daisuke-ym/pinball/src/main-controller/lcd.md

# SC2004 液晶ディスプレイに表示する内容

```
  01234567890123456789
0 S:a         BMPR SL
1 O E J T TGT #### ##
2 b c d e fff ST BS BT
3 * * * * *** *% *% *%
```

*: テレメトリ - \ | /
%: 値

S: 現在のステージ
  a: 
O: アウトホール
  b: W P
E: エクストラボール
  c: W S
J: ジャンパー
  d: W U
T: タイマー
  e: W C U
TGT: ドロップターゲット
  fff: H U D

BMPR: バンパー
  ####: H *
SL: スリングショット
  ####: H *

ST: スタンダップターゲット
BS: ボールセパレータ
BT: ボールスルー
