daisuke-ym/pinball/PCB/attiny1616-hbridge/attiny1616-hbridge.kicad_pcb

## KiCad design PCB/attiny1616-hbridge/attiny1616-hbridge.kicad_pcb (2026-10-16)

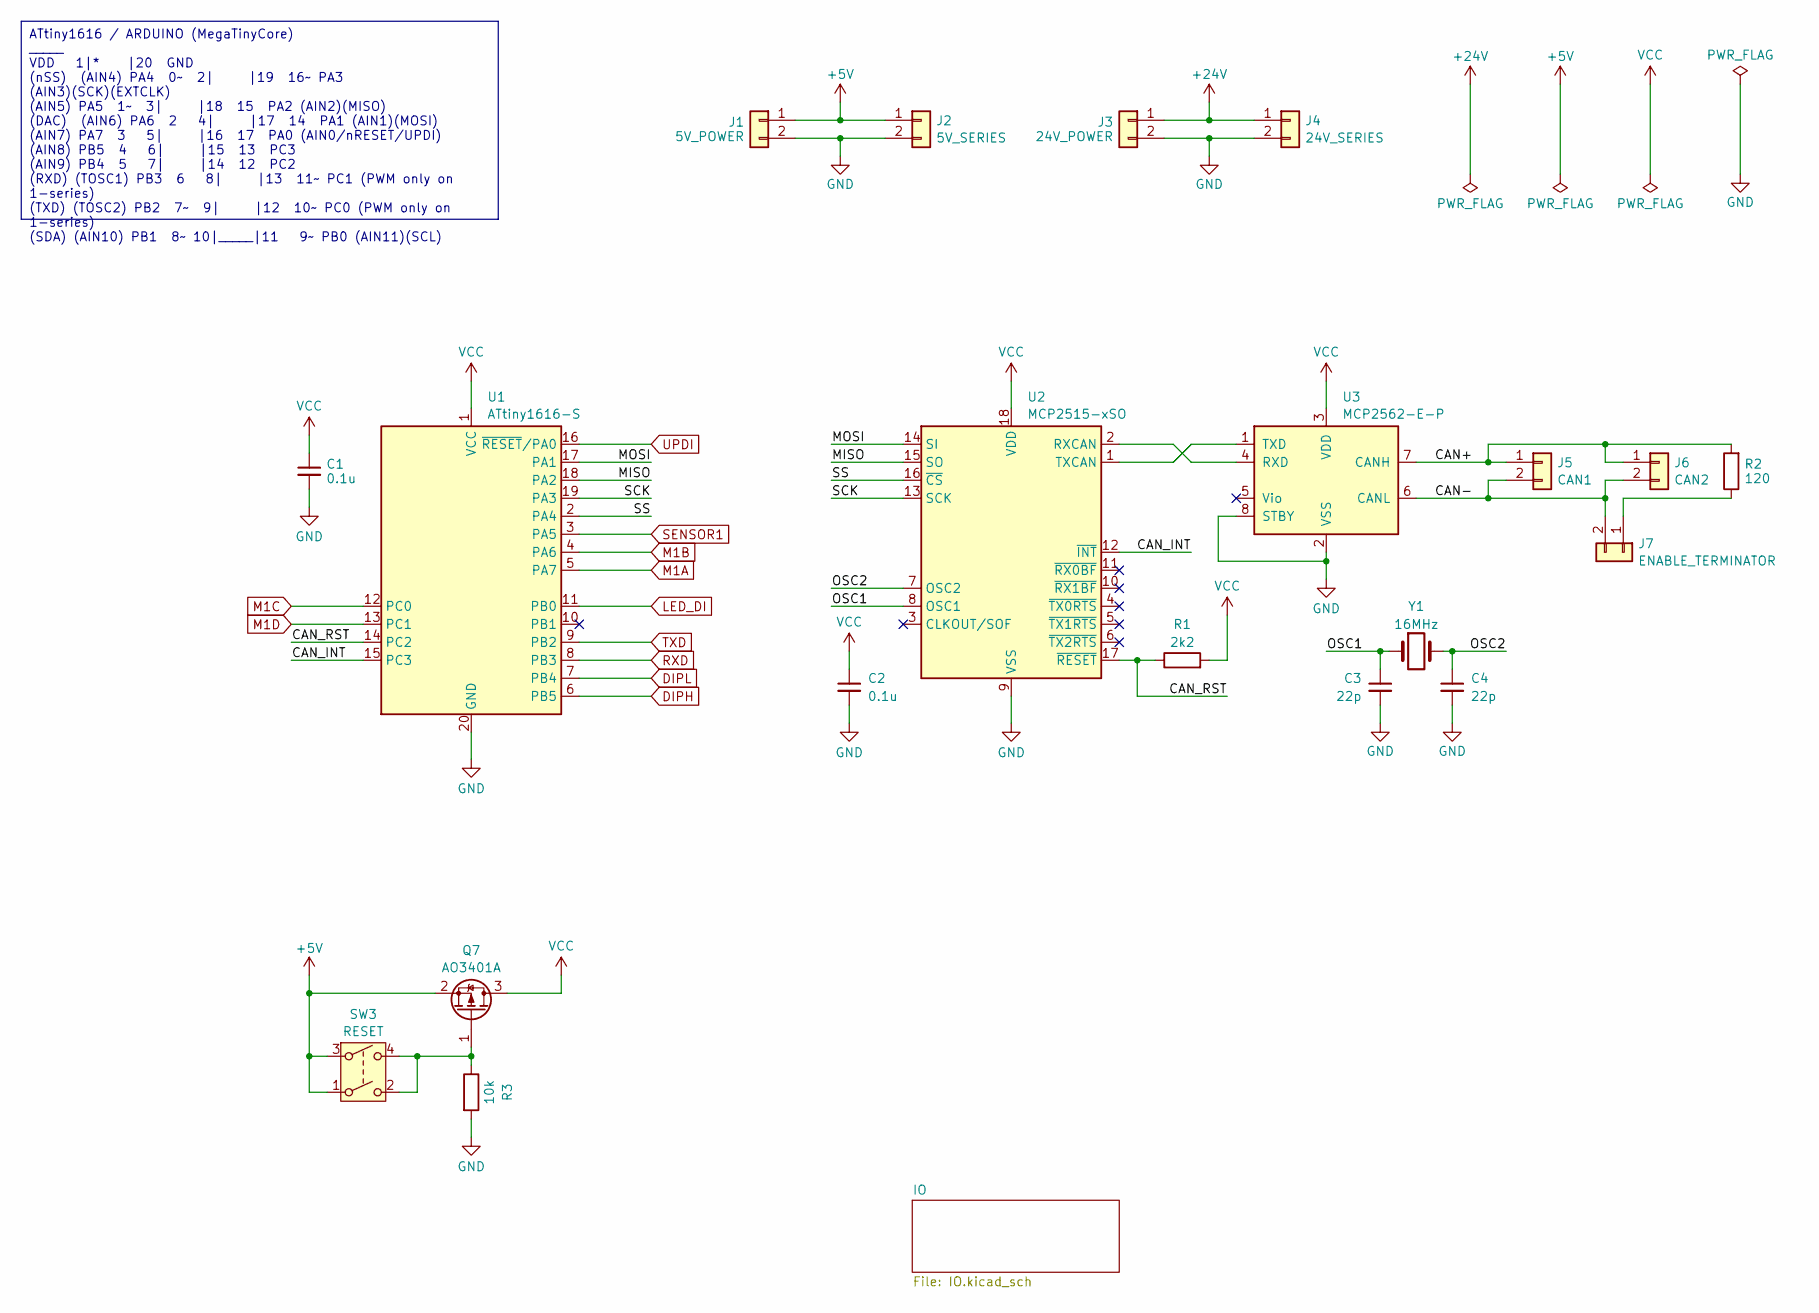
[picture p1: schematic attiny1616-hbridge.kicad_sch]

Parts:
C1, C2: 0.1u; C_0402_1005Metric; LCSC C307331
C3, C4: 22p; C_0402_1005Metric; LCSC C1555
J1: 5V_POWER; JST_XH_B2B-XH-A_1x02_P2.50mm_Vertical
J2: 5V_SERIES; JST_XH_B2B-XH-A_1x02_P2.50mm_Vertical
J3: 24V_POWER; JST_XH_B2B-XH-A_1x02_P2.50mm_Vertical
J4: 24V_SERIES; JST_XH_B2B-XH-A_1x02_P2.50mm_Vertical
J5: CAN1; JST_XH_B2B-XH-A_1x02_P2.50mm_Vertical
J6: CAN2; JST_XH_B2B-XH-A_1x02_P2.50mm_Vertical
J7: ENABLE_TERMINATOR; PinHeader_1x02_P2.54mm_Vertical
Q7: AO3401A; SOT-23; LCSC C15127
R1: 2k2; R_0402_1005Metric; LCSC C25879
R2: 120; R_0402_1005Metric; LCSC C25079
R3: 10k; R_0402_1005Metric; LCSC C25744
SW3: RESET; DTS-6-V-2
U1: ATtiny1616-S; SOIC-20W_7.5x12.8mm_P1.27mm
U2: MCP2515-xSO; DIP-18_W7.62mm_Socket
U3: MCP2562-E-P; DIP-8_W7.62mm
Y1: 16MHz; Crystal_SMD_3225-4Pin_3.2x2.5mm; LCSC C13738

Connections:
+5V: J1.1, J2.1, Q7.2 (S), SW3.1, SW3.3; also elsewhere on the board
+24V: J3.1, J4.1; also elsewhere on the board
/CAN+: J5.1, J6.1, R2.2, U3.7 (CANH)
/CAN-: J5.2, J6.2, J7.2, U3.6 (CANL)
/CAN_INT: U1.15 (PC3), U2.12 (~INT)
/CAN_RST: R1.1, U1.14 (PC2), U2.17 (~RESET)
/MISO: U1.18 (PA2), U2.15 (SO)
/MOSI: U1.17 (PA1), U2.14 (SI)
/OSC1: C3.1, U2.8 (OSC1), Y1.1
/OSC2: C4.1, U2.7 (OSC2), Y1.2
/SCK: U1.19 (PA3), U2.13 (SCK)
/SS: U1.2 (PA4), U2.16 (~CS)
DIPH: U1.6 (PB5); also elsewhere on the board
DIPL: U1.7 (PB4); also elsewhere on the board
GND: C1.2, C2.2, C3.2, C4.2, J1.2, J2.2, J3.2, J4.2, R3.2, U1.20 (GND), U2.9 (VSS), U3.2 (VSS), U3.8 (STBY); also elsewhere on the board
LED_DI: U1.11 (PB0); also elsewhere on the board
M1A: U1.5 (PA7); also elsewhere on the board
M1B: U1.4 (PA6); also elsewhere on the board
M1C: U1.12 (PC0); also elsewhere on the board
M1D: U1.13 (PC1); also elsewhere on the board
unnamed: J7.1, R2.1
unnamed: Q7.1 (G), R3.1, SW3.2, SW3.4
unnamed: U2.2 (RXCAN), U3.4 (RXD)
unnamed: U2.1 (TXCAN), U3.1 (TXD)
RXD: U1.8 (PB3); also elsewhere on the board
SENSOR1: U1.3 (PA5); also elsewhere on the board
TXD: U1.9 (PB2); also elsewhere on the board
UPDI: U1.16 (~RESET/PA0); also elsewhere on the board
VCC: C1.1, C2.1, Q7.3 (D), R1.2, U1.1 (VCC), U2.18 (VDD), U3.3 (VDD)

Notes on the sheet:
ATtiny1616 / ARDUINO (MegaTinyCore) _____ VDD 1|* |20 GND (nSS) (AIN4) PA4 0~ 2| |19 16~ PA3 (AIN3)(SCK)(EXTCLK) (AIN5) PA5 1~ 3| |18 15 PA2 (AIN2)(MISO) (DAC) (AIN6) PA6 2 4| |17 14 PA1 (AIN1)(MOSI) (AIN7) PA7 3 5| |16 17 PA0 (AIN0/nRESET/UPDI) (AIN8) PB5 4 6| |15 13 PC3 (AIN9) PB4 5 7| |14 12 PC2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

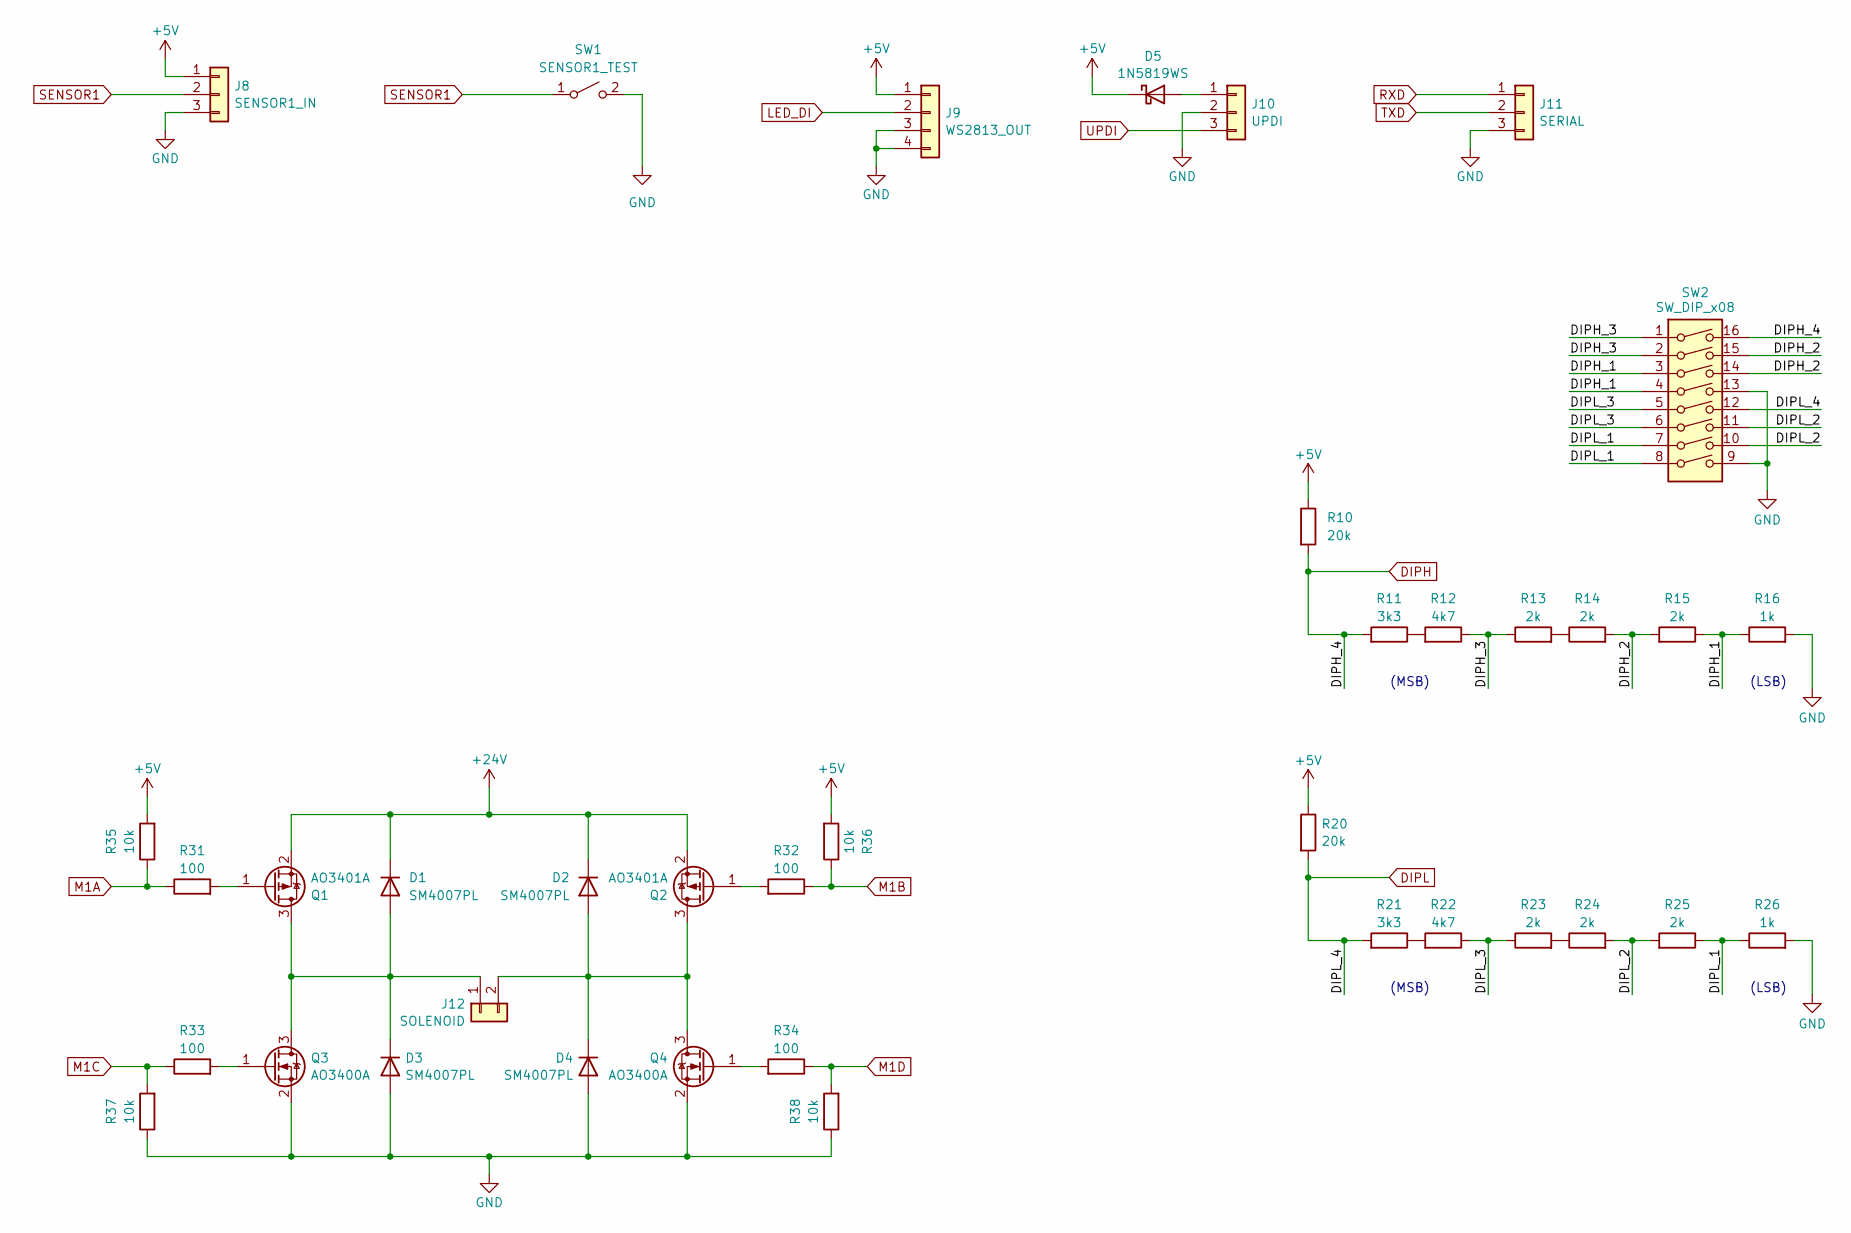
[picture p2: schematic IO.kicad_sch]

Parts:
D1, D2, D3, D4: SM4007PL; D_SOD-123F; LCSC C64898
D5: 1N5819WS; D_SOD-323; LCSC C191023
J8: SENSOR1_IN; JST_XH_B3B-XH-A_1x03_P2.50mm_Vertical
J9: WS2813_OUT; JST_XH_B4B-XH-A_1x04_P2.50mm_Vertical
J10: UPDI; PinHeader_1x03_P2.54mm_Vertical
J11: SERIAL; PinHeader_1x03_P2.54mm_Vertical
J12: SOLENOID; TB111-2-2
Q1, Q2: AO3401A; SOT-23; LCSC C15127
Q3, Q4: AO3400A; SOT-23; LCSC C20917
R10, R20: 20k; R_0402_1005Metric; LCSC C25765
R11, R21: 3k3; R_0402_1005Metric; LCSC C25890
R12, R22: 4k7; R_0402_1005Metric; LCSC C25900
R13, R14, R15, R23, R24, R25: 2k; R_0402_1005Metric; LCSC C4109
R16, R26: 1k; R_0402_1005Metric; LCSC C11702
R31, R32, R33, R34: 100; R_0402_1005Metric; LCSC C25077
R35, R36, R37, R38: 10k; R_0402_1005Metric; LCSC C25744
SW1: SENSOR1_TEST; TS-1088-AR02016; LCSC C720477
SW2: SW_DIP_x08; SW_DIP_SPSTx08_Slide_9.78x22.5mm_W7.62mm_P2.54mm

Connections:
+5V: D5.1 (K), J8.1, J9.1, R10.1, R20.1, R35.2, R36.2; also elsewhere on the board
+24V: D1.1 (K), D2.1 (K), Q1.2 (S), Q2.2 (S); also elsewhere on the board
/IO/DIPH_1: R15.1, R16.1, SW2.3, SW2.4
/IO/DIPH_2: R14.2, R15.2, SW2.14, SW2.15
/IO/DIPH_3: R12.1, R13.1, SW2.1, SW2.2
/IO/DIPL_1: R25.1, R26.1, SW2.7, SW2.8
/IO/DIPL_2: R24.2, R25.2, SW2.10, SW2.11
/IO/DIPL_3: R22.1, R23.1, SW2.5, SW2.6
DIPH: R10.2, R11.2, SW2.16; also elsewhere on the board
DIPL: R20.2, R21.2, SW2.12; also elsewhere on the board
GND: D3.2 (A), D4.2 (A), J8.3, J9.3, J9.4, J10.2, J11.3, Q3.2 (S), Q4.2 (S), R16.2, R26.2, R37.1, R38.1, SW1.2 (B), SW2.9, SW2.13; also elsewhere on the board
LED_DI: J9.2; also elsewhere on the board
M1A: R31.1, R35.1; also elsewhere on the board
M1B: R32.1, R36.1; also elsewhere on the board
M1C: R33.1, R37.2; also elsewhere on the board
M1D: R34.1, R38.2; also elsewhere on the board
unnamed: D1.2 (A), D3.1 (K), J12.1, Q1.3 (D), Q3.3 (D)
unnamed: D2.2 (A), D4.1 (K), J12.2, Q2.3 (D), Q4.3 (D)
unnamed: D5.2 (A), J10.1
unnamed: Q1.1 (G), R31.2
unnamed: Q2.1 (G), R32.2
unnamed: Q3.1 (G), R33.2
unnamed: Q4.1 (G), R34.2
unnamed: R11.1, R12.2
unnamed: R13.2, R14.1
unnamed: R21.1, R22.2
unnamed: R23.2, R24.1
RXD: J11.1; also elsewhere on the board
SENSOR1: J8.2, SW1.1 (A); also elsewhere on the board
TXD: J11.2; also elsewhere on the board
UPDI: J10.3; also elsewhere on the board

Notes on the sheet:
(LSB)
(MSB)

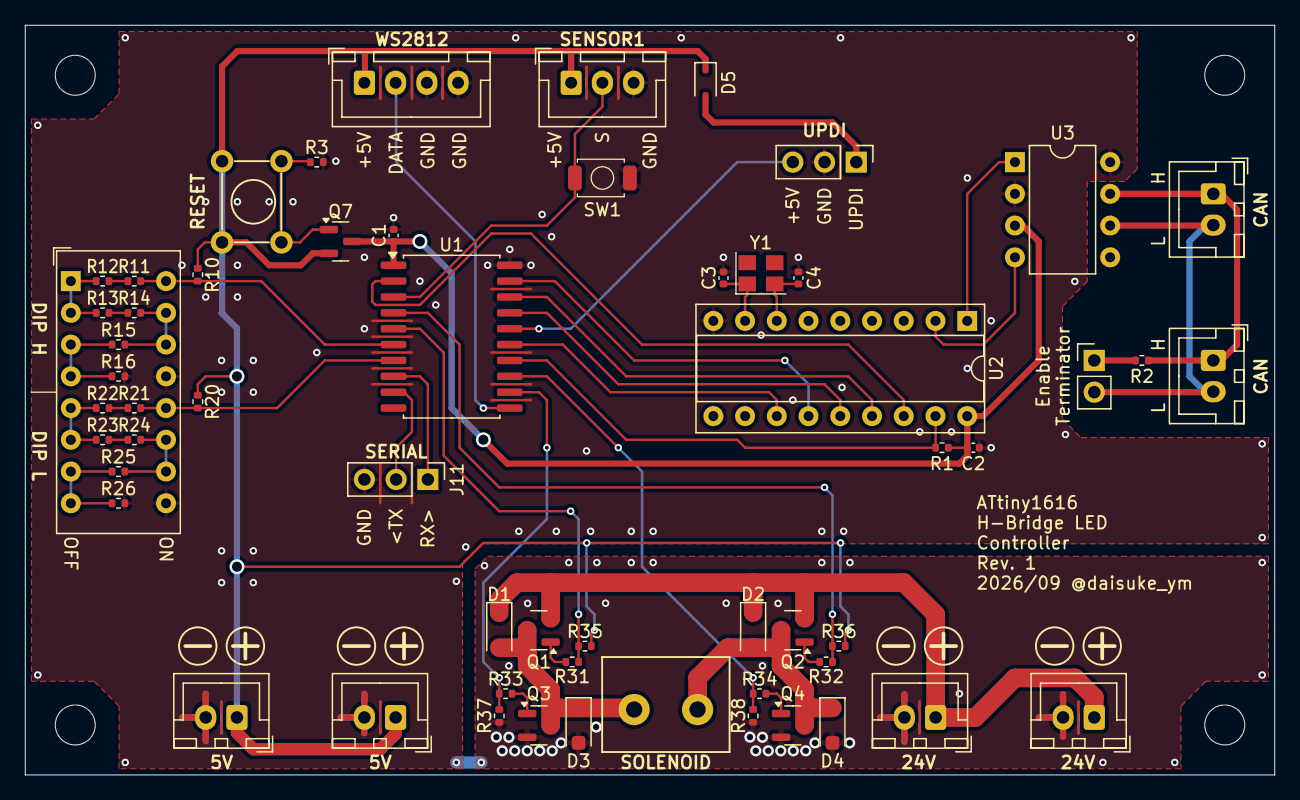
[picture p3: board attiny1616-hbridge.kicad_pcb from above]

Board: 2 copper layers, 100.0 x 60.0 mm, 58 parts (0 on the bottom side), 46 nets.
