daisuke-ym/pinball/PCB/photo-int/photo-int.kicad_pcb

## KiCad design PCB/photo-int/photo-int.kicad_pcb (2026-10-16)

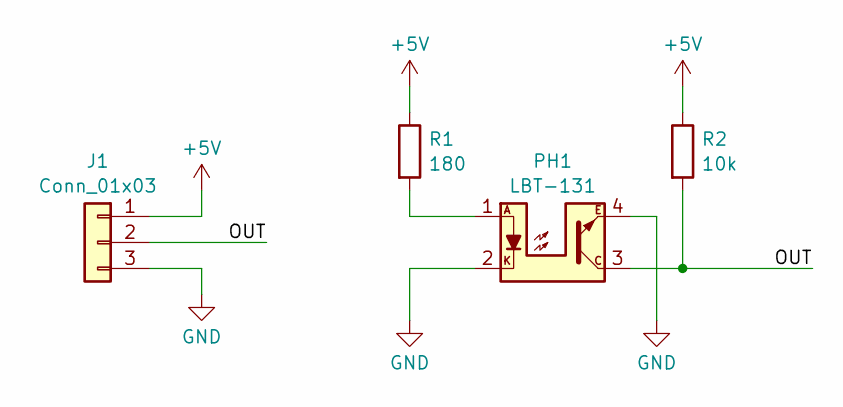
[picture p4: schematic photo-int.kicad_sch]

Parts:
J1: Conn_01x03; PinHeader_1x03_P2.54mm_Vertical
PH1: LBT-131
R1: 180; R_0603_1608Metric_Pad0.98x0.95mm_HandSolder
R2: 10k; R_0603_1608Metric_Pad0.98x0.95mm_HandSolder

Connections:
+5V: J1.1, R1.1, R2.1
/OUT: J1.2, PH1.3, R2.2
GND: J1.3, PH1.2, PH1.4
unnamed: PH1.1, R1.2

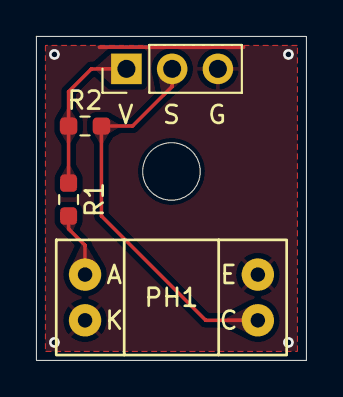
[picture p5: board photo-int.kicad_pcb from above]

Board: 2 copper layers, 15.0 x 18.0 mm, 4 parts (0 on the bottom side), 4 nets.
