daisuke-ym/pinball/PCB/esp32-mainboard/esp32-mainboard.kicad_pcb

## KiCad design PCB/esp32-mainboard/esp32-mainboard.kicad_pcb (2026-10-16)

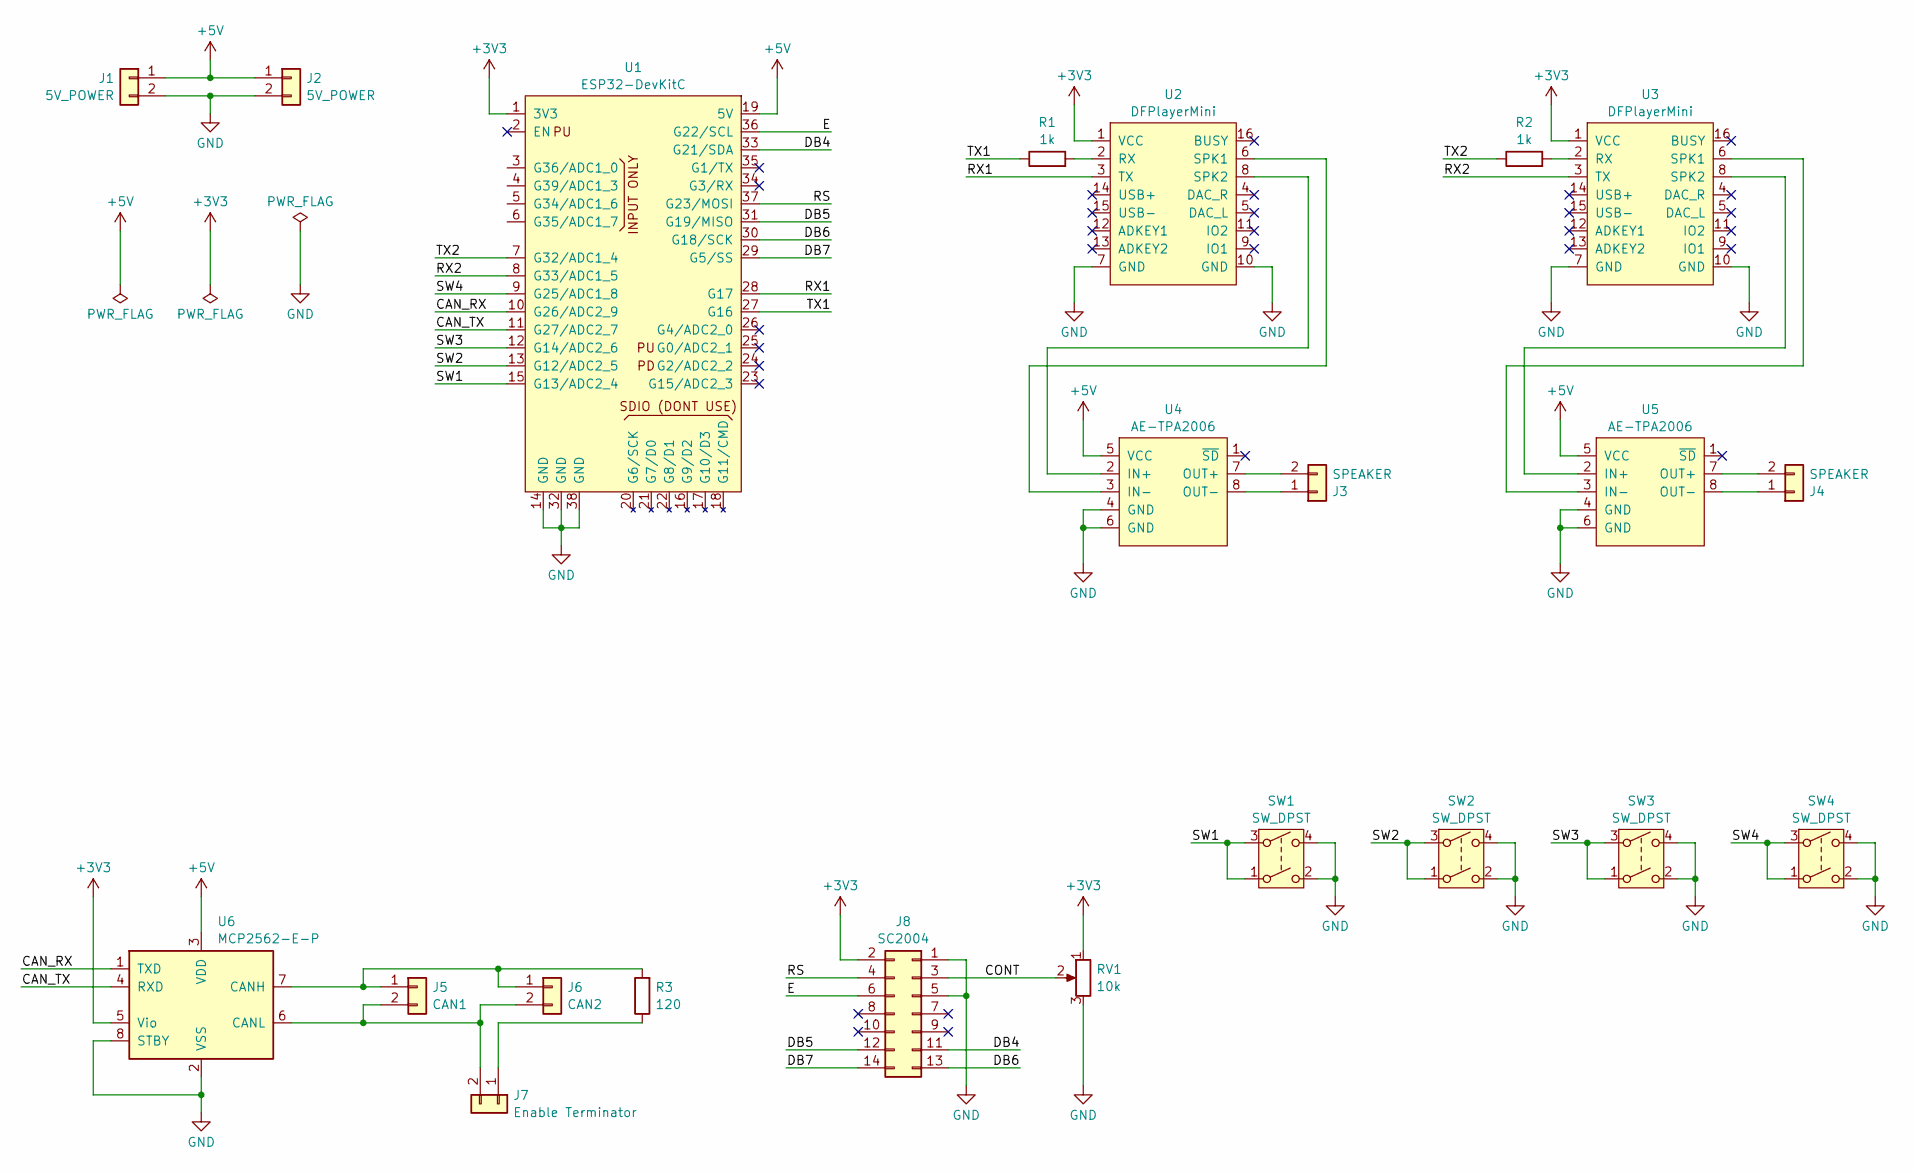
[picture p6: schematic esp32-mainboard.kicad_sch]

Parts:
J1, J2: 5V_POWER; JST_XH_B2B-XH-A_1x02_P2.50mm_Vertical
J3, J4: SPEAKER; JST_XH_B2B-XH-A_1x02_P2.50mm_Vertical
J5: CAN1; JST_XH_B2B-XH-A_1x02_P2.50mm_Vertical
J6: CAN2; JST_XH_B2B-XH-A_1x02_P2.50mm_Vertical
J7: Enable Terminator; PinHeader_1x02_P2.54mm_Vertical
J8: SC2004; PinHeader_2x07_P2.54mm_Vertical
R1, R2: 1k; R_Axial_DIN0207_L6.3mm_D2.5mm_P10.16mm_Horizontal
R3: 120; R_Axial_DIN0207_L6.3mm_D2.5mm_P10.16mm_Horizontal
RV1: 10k; Potentiometer_Bourns_3339P_Vertical
SW1, SW2, SW3, SW4: SW_DPST; DTS-6-V-2
U1: ESP32-DevKitC
U2, U3: DFPlayerMini
U4, U5: AE-TPA2006; PinSocket_1x08_P2.54mm_Vertical
U6: MCP2562-E-P; DIP-8_W7.62mm

Connections:
+3V3: J8.2, RV1.1, U1.1 (3V3), U2.1 (VCC), U3.1 (VCC), U6.5 (Vio)
+5V: J1.1, J2.1, U1.19 (5V), U4.5 (VCC), U5.5 (VCC), U6.3 (VDD)
/CAN_RX: U1.10 (G26/ADC2_9), U6.1 (TXD)
/CAN_TX: U1.11 (G27/ADC2_7), U6.4 (RXD)
/CONT: J8.3, RV1.2
/DB4: J8.11, U1.33 (G21/SDA)
/DB5: J8.12, U1.31 (G19/MISO)
/DB6: J8.13, U1.30 (G18/SCK)
/DB7: J8.14, U1.29 (G5/SS)
/E: J8.6, U1.36 (G22/SCL)
/RS: J8.4, U1.37 (G23/MOSI)
/RX1: U1.28 (G17), U2.3 (TX)
/RX2: U1.8 (G33/ADC1_5), U3.3 (TX)
/SW1: SW1.1, SW1.3, U1.15 (G13/ADC2_4)
/SW2: SW2.1, SW2.3, U1.13 (G12/ADC2_5)
/SW3: SW3.1, SW3.3, U1.12 (G14/ADC2_6)
/SW4: SW4.1, SW4.3, U1.9 (G25/ADC1_8)
/TX1: R1.1, U1.27 (G16)
/TX2: R2.1, U1.7 (G32/ADC1_4)
GND: J1.2, J2.2, J8.1, J8.5, RV1.3, SW1.2, SW1.4, SW2.2, SW2.4, SW3.2, SW3.4, SW4.2, SW4.4, U1.14 (GND), U1.32 (GND), U1.38 (GND), U2.7 (GND), U2.10 (GND), U3.7 (GND), U3.10 (GND), U4.4 (GND), U4.6 (GND), U5.4 (GND), U5.6 (GND), U6.2 (VSS), U6.8 (STBY)
unnamed: J3.1, U4.8 (OUT-)
unnamed: J3.2, U4.7 (OUT+)
unnamed: J4.1, U5.8 (OUT-)
unnamed: J4.2, U5.7 (OUT+)
unnamed: J5.1, J6.1, R3.2, U6.7 (CANH)
unnamed: J5.2, J6.2, J7.2, U6.6 (CANL)
unnamed: J7.1, R3.1
unnamed: R1.2, U2.2 (RX)
unnamed: U2.6 (SPK1), U4.3 (IN-)
unnamed: U2.8 (SPK2), U4.2 (IN+)
unnamed: R2.2, U3.2 (RX)
unnamed: U3.6 (SPK1), U5.3 (IN-)
unnamed: U3.8 (SPK2), U5.2 (IN+)

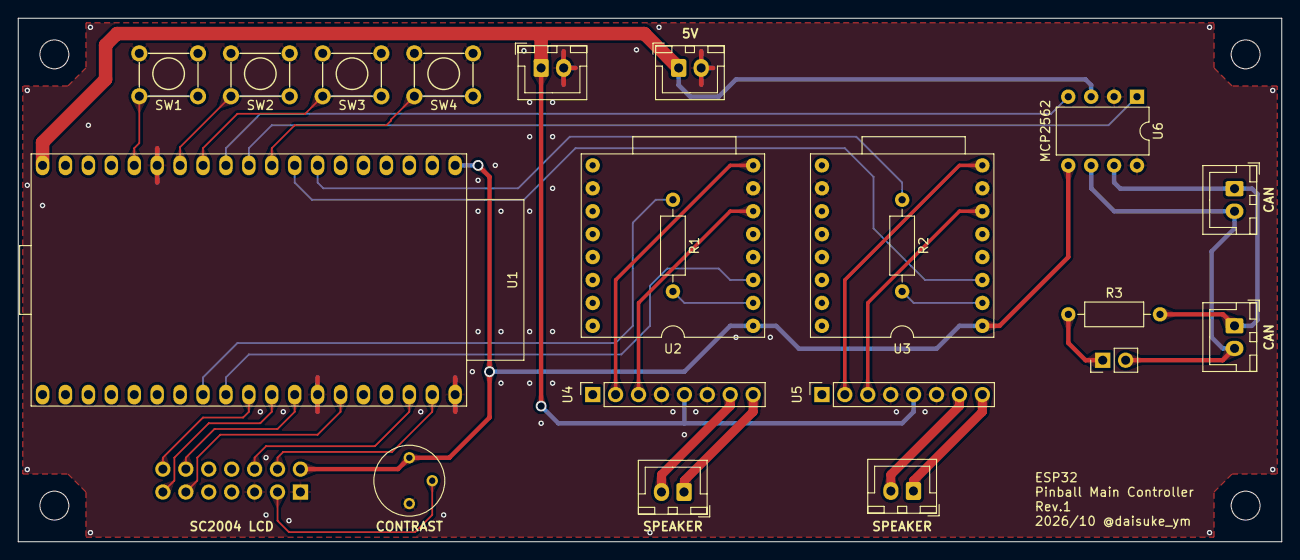
[picture p7: board esp32-mainboard.kicad_pcb from above]

Board: 2 copper layers, 140.0 x 58.0 mm, 26 parts (1 on the bottom side), 33 nets.

Other parts of the board:
MH1, MH2, MH3, MH4: MountingHole_3.2mm_M3
