daisuke-ym/pinball/PCB/attiny1616-spi7seg/attiny1616-spi7seg.kicad_pcb

## KiCad design PCB/attiny1616-spi7seg/attiny1616-spi7seg.kicad_pcb (2026-10-16)

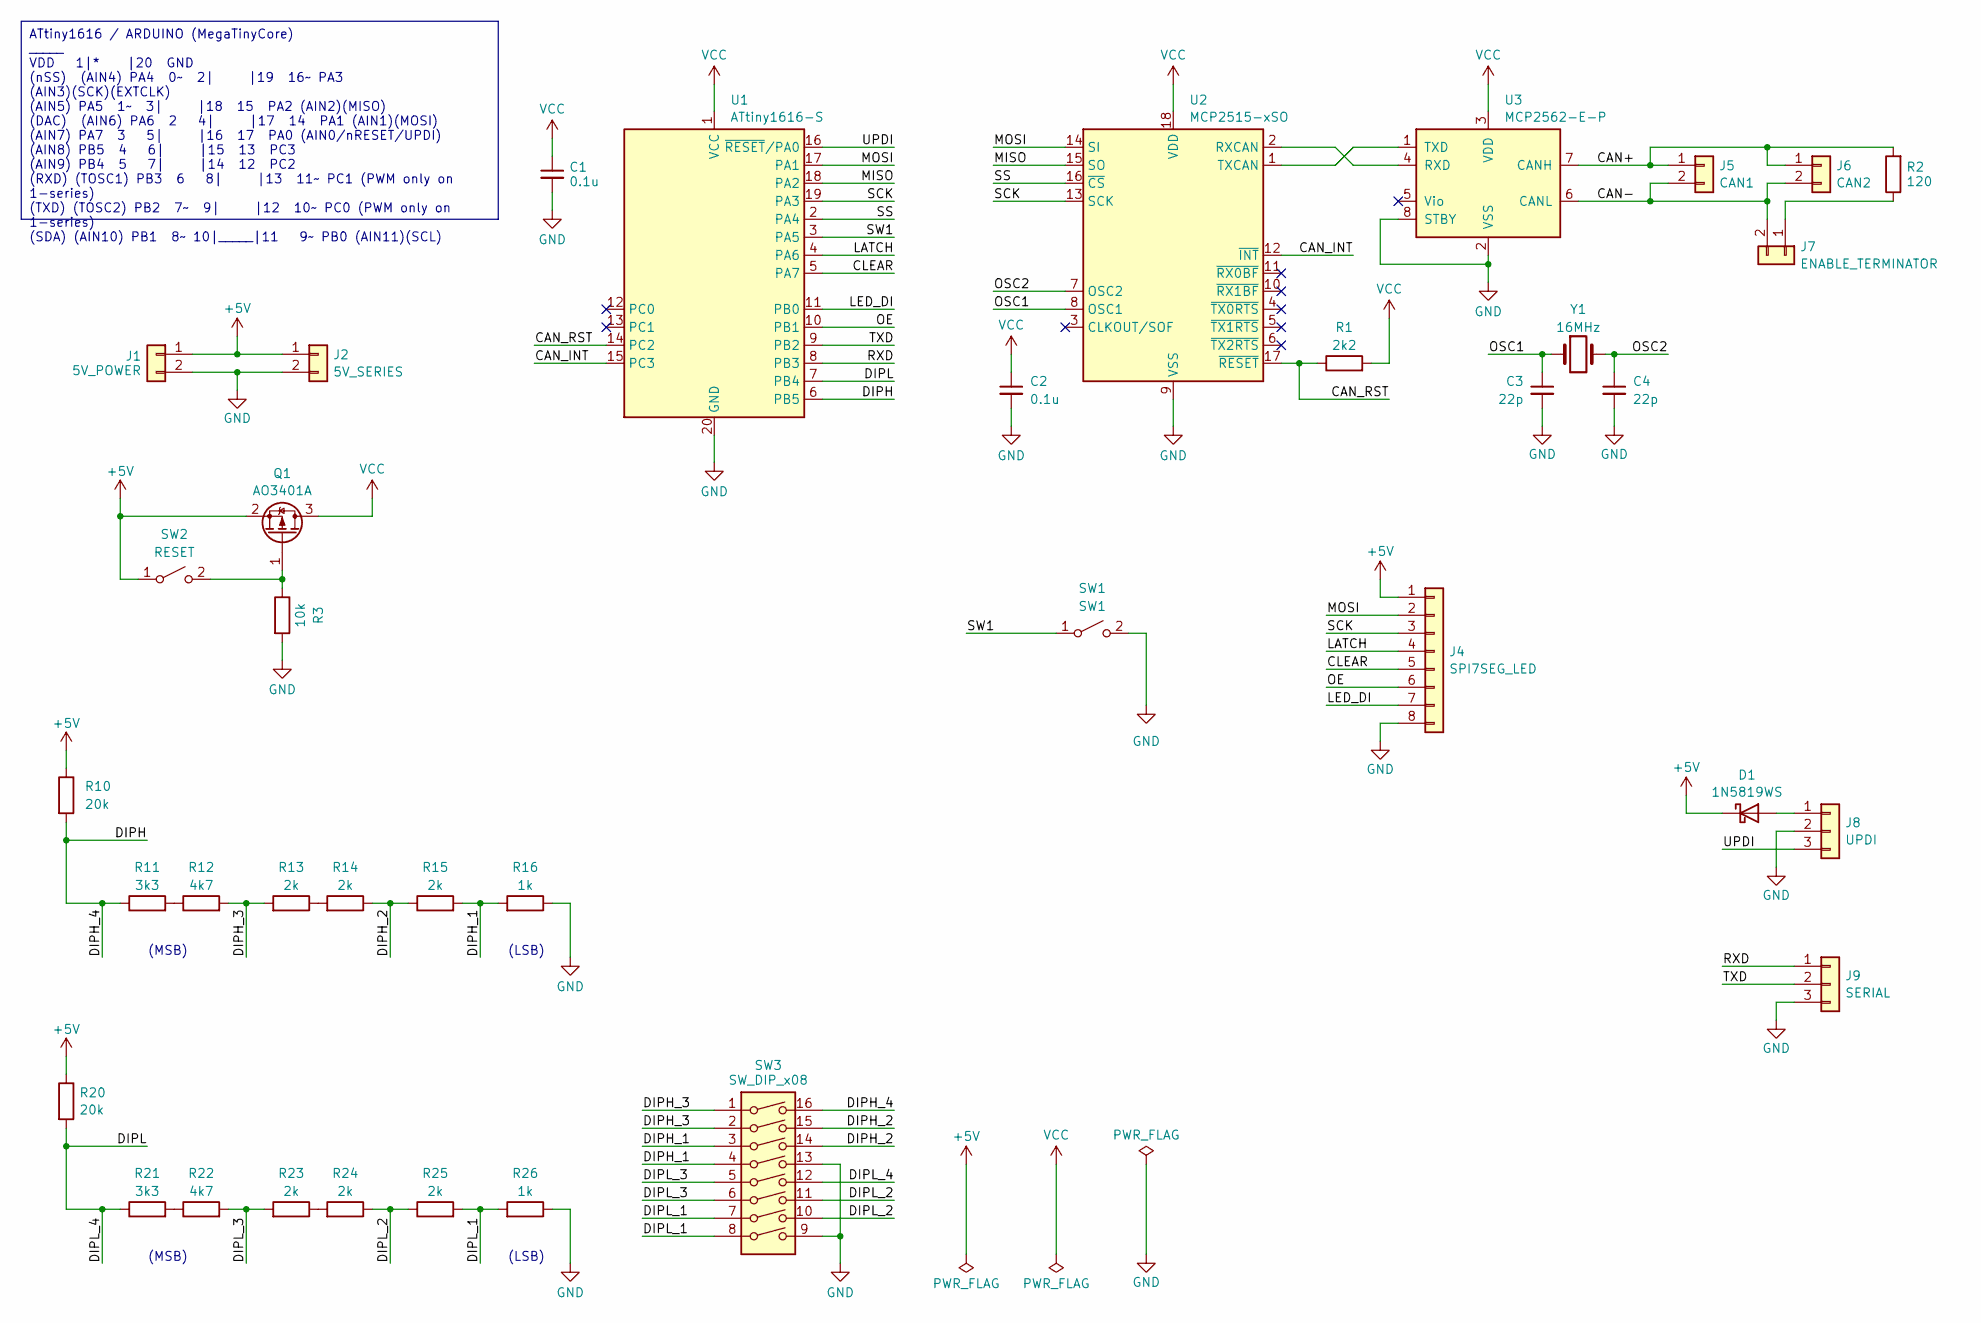
[picture p8: schematic attiny1616-spi7seg.kicad_sch]

Parts:
C1, C2: 0.1u; C_0402_1005Metric; LCSC C307331
C3, C4: 22p; C_0402_1005Metric; LCSC C1555
D1: 1N5819WS; D_SOD-323; LCSC C191023
J1: 5V_POWER; JST_XH_B2B-XH-A_1x02_P2.50mm_Vertical
J2: 5V_SERIES; JST_XH_B2B-XH-A_1x02_P2.50mm_Vertical
J4: SPI7SEG_LED; PinHeader_1x08_P2.54mm_Vertical
J5: CAN1; JST_XH_B2B-XH-A_1x02_P2.50mm_Vertical
J6: CAN2; JST_XH_B2B-XH-A_1x02_P2.50mm_Vertical
J7: ENABLE_TERMINATOR; PinHeader_1x02_P2.54mm_Vertical
J8: UPDI; PinHeader_1x03_P2.54mm_Vertical
J9: SERIAL; PinHeader_1x03_P2.54mm_Vertical
Q1: AO3401A; SOT-23; LCSC C15127
R1: 2k2; R_0402_1005Metric; LCSC C25879
R2: 120; R_0402_1005Metric; LCSC C25079
R3: 10k; R_0402_1005Metric; LCSC C25744
R10, R20: 20k; R_0402_1005Metric; LCSC C25765
R11, R21: 3k3; R_0402_1005Metric; LCSC C25890
R12, R22: 4k7; R_0402_1005Metric; LCSC C25900
R13, R14, R15, R23, R24, R25: 2k; R_0402_1005Metric; LCSC C4109
R16, R26: 1k; R_0402_1005Metric; LCSC C11702
SW1: SW1; TS-1088-AR02016; LCSC C720477
SW2: RESET; TS-1088-AR02016; LCSC C720477
SW3: SW_DIP_x08; SW_DIP_SPSTx08_Slide_9.78x22.5mm_W7.62mm_P2.54mm
U1: ATtiny1616-S; SOIC-20W_7.5x12.8mm_P1.27mm
U2: MCP2515-xSO; DIP-18_W7.62mm_Socket
U3: MCP2562-E-P; DIP-8_W7.62mm
Y1: 16MHz; Crystal_SMD_3225-4Pin_3.2x2.5mm; LCSC C13738

Connections:
+5V: D1.1 (K), J1.1, J2.1, J4.1, Q1.2 (S), R10.1, R20.1, SW2.1 (A)
/CAN+: J5.1, J6.1, R2.2, U3.7 (CANH)
/CAN-: J5.2, J6.2, J7.2, U3.6 (CANL)
/CAN_INT: U1.15 (PC3), U2.12 (~INT)
/CAN_RST: R1.1, U1.14 (PC2), U2.17 (~RESET)
/CLEAR: J4.5, U1.5 (PA7)
/DIPH: R10.2, R11.1, SW3.16, U1.6 (PB5)
/DIPH_1: R15.2, R16.2, SW3.3, SW3.4
/DIPH_2: R14.1, R15.1, SW3.14, SW3.15
/DIPH_3: R12.2, R13.2, SW3.1, SW3.2
/DIPL: R20.2, R21.1, SW3.12, U1.7 (PB4)
/DIPL_1: R25.2, R26.2, SW3.7, SW3.8
/DIPL_2: R24.1, R25.1, SW3.10, SW3.11
/DIPL_3: R22.2, R23.2, SW3.5, SW3.6
/LATCH: J4.4, U1.4 (PA6)
/LED_DI: J4.7, U1.11 (PB0)
/MISO: U1.18 (PA2), U2.15 (SO)
/MOSI: J4.2, U1.17 (PA1), U2.14 (SI)
/OE: J4.6, U1.10 (PB1)
/OSC1: C3.1, U2.8 (OSC1), Y1.1
/OSC2: C4.1, U2.7 (OSC2), Y1.2
/RXD: J9.1, U1.8 (PB3)
/SCK: J4.3, U1.19 (PA3), U2.13 (SCK)
/SS: U1.2 (PA4), U2.16 (~CS)
/SW1: SW1.1 (A), U1.3 (PA5)
/TXD: J9.2, U1.9 (PB2)
/UPDI: J8.3, U1.16 (~RESET/PA0)
GND: C1.2, C2.2, C3.2, C4.2, J1.2, J2.2, J4.8, J8.2, J9.3, R3.2, R16.1, R26.1, SW1.2 (B), SW3.9, SW3.13, U1.20 (GND), U2.9 (VSS), U3.2 (VSS), U3.8 (STBY)
unnamed: D1.2 (A), J8.1
unnamed: J7.1, R2.1
unnamed: Q1.1 (G), R3.1, SW2.2 (B)
unnamed: R11.2, R12.1
unnamed: R13.1, R14.2
unnamed: R21.2, R22.1
unnamed: R23.1, R24.2
unnamed: U2.2 (RXCAN), U3.4 (RXD)
unnamed: U2.1 (TXCAN), U3.1 (TXD)
VCC: C1.1, C2.1, Q1.3 (D), R1.2, U1.1 (VCC), U2.18 (VDD), U3.3 (VDD)

Notes on the sheet:
ATtiny1616 / ARDUINO (MegaTinyCore) _____ VDD 1|* |20 GND (nSS) (AIN4) PA4 0~ 2| |19 16~ PA3 (AIN3)(SCK)(EXTCLK) (AIN5) PA5 1~ 3| |18 15 PA2 (AIN2)(MISO) (DAC) (AIN6) PA6 2 4| |17 14 PA1 (AIN1)(MOSI) (AIN7) PA7 3 5| |16 17 PA0 (AIN0/nRESET/UPDI) (AIN8) PB5 4 6| |15 13 PC3 (AIN9) PB4 5 7| |14 12 PC2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
(LSB)
(MSB)

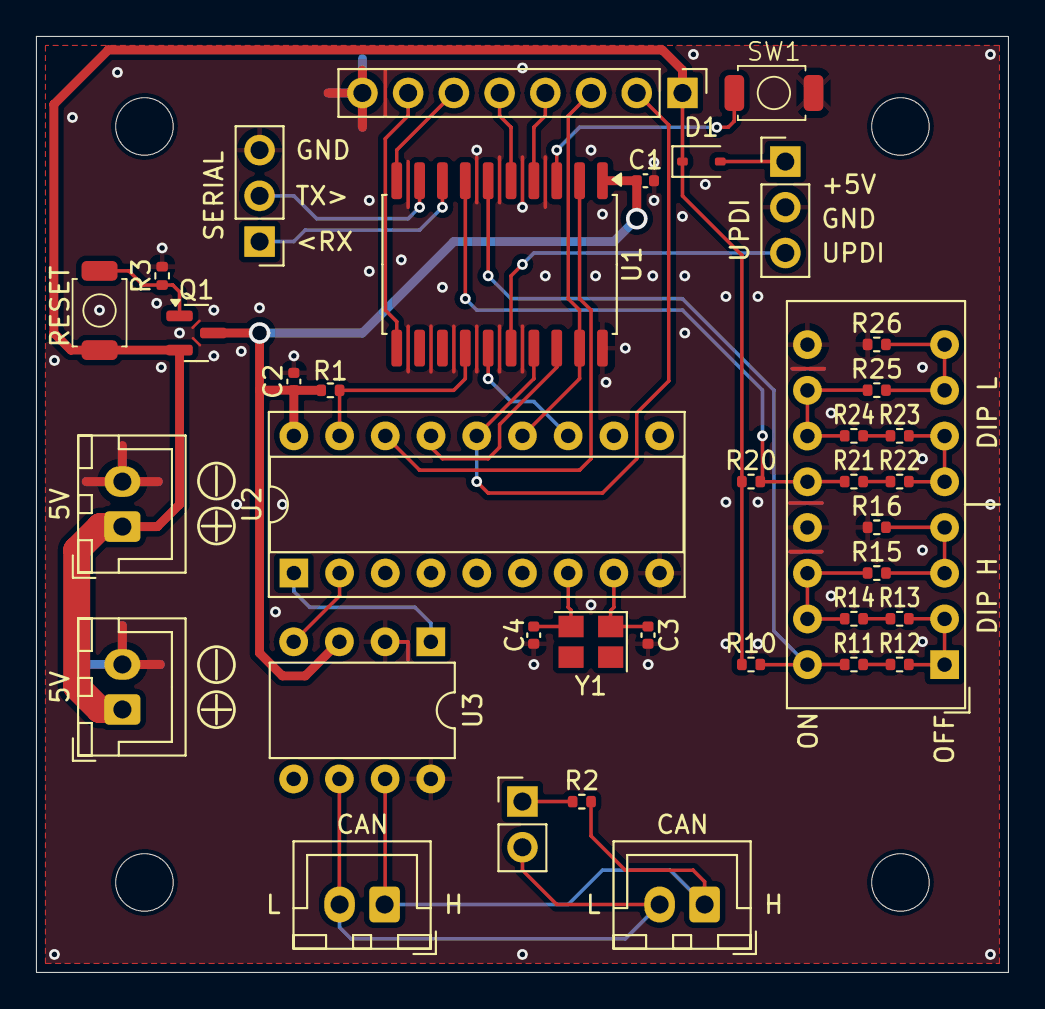
[picture p9: board attiny1616-spi7seg.kicad_pcb from above]

Board: 2 copper layers, 54.0 x 52.0 mm, 38 parts (0 on the bottom side), 38 nets.
