daisuke-ym/pinball/(commit log)

2025-10-21 CAN通信の内容をLCDとシリアルモニタに表示するためのコードを追加しました。
2025-10-21 シリアル通信で受信したCANデータを処理し、CANバスに送信する機能を追加しました。
2025-10-21 待機時はLEDが七色に変化、 コマンドを受け取ると、カウントダウン、停止を行う。
2025-10-22 タイマーのコマンド定義を修正した。
2025-10-22 Revert "タイマーのコマンド定義を修正した。"
    This reverts commit 36e2042de882faaccff6d24737135bc5fc7ae6d7.
2025-10-22 得点表示板コントローラの初回コミット
2025-10-22 得点表示板のコマンド定義を修正しました。
2025-10-22 テレメトリー送信間隔を5秒に変更した。
2025-10-22 タイマーからのテレメトリ情報をLCDに表示する機能を追加した。
2025-10-22 ドロップターゲットコントローラの初回コミット
2025-10-22 ドロップターゲットからのテレメトリ情報をLCDに表示する機能を追加した。
2025-10-23 ジャンパーコントローラの初回コミット
2025-10-23 ジャンパーからのテレメトリ情報をLCDに表示する機能を追加した。
2025-10-23 受信フィルターをCANIDに合わせて設定するように修正した。
2025-10-23 定期的にテレメトリ情報を送信するコードを追加した。
2025-10-24 ハイスコアをEEPROMに保存・読み込みする機能を追加した。
2025-10-24 得点板制御コマンドを追加した。
2025-10-24 スタンダップターゲットの初回コミット
2025-10-24 スタンダップターゲットのテレメトリ情報をLCDに表示する機能を追加した。
2025-10-24 スリングショットからのテレメトリ情報をLCDに表示する機能を追加した。
2025-10-24 ドロップターゲット、スリングショットの表示位置を修正した。
2025-10-24 スリングショットコントローラの初回コミット
2025-10-28 バンパーコントローラの初回コミット
2025-10-28 コマンドの定義を修正した。
2025-10-28 バンパーのテレメトリ情報をLCDに表示する機能を追加した。
2025-10-28 アクションがあったときに、その状態をCANで送信するように変更した。
2025-10-28 ドロップターゲットのテレメトリ情報の表示方法を変更した。
2025-10-28 ボールセパレータ・コントローラの初回コミット
2025-10-28 ボールスルー、ボールセパレーターのテレメトリ情報をLCDに表示する機能を追加した。
2025-10-28 テレメトリ情報を変更した。
2025-10-28 ジャンパーのテレメトリ情報の表示方法を変更した。
2025-10-29 タイマーだけを動かすブランチ。 タイマーと同時にLEDを制御しようとすると、CAN通信が不安定になるため、 一旦LED制御を外す。
2025-10-29 アウトホールのテレメトリ情報をLCDに表示するようにした。
2025-10-29 LCDの表示方法を修正して、各種情報が見やすくなるようにしました。
2025-10-29 アウトホールコントローラの初回コミット
2025-10-29 エクストラボールコントローラの初回コミット
2025-10-29 制御の方法を変更した。
2025-10-29 エクストラボールのテレメトリ情報をLCDに表示するようにしました。
2025-10-30 ゲーム中かどうかを送信するように修正した。
2025-10-30 LibreOfficeのロックファイルを無視するようにした。
2025-10-30 defines.h を def-can.h と def-vars.h に分割しました。
2025-10-30 ゲーム開始前に盤面の初期化をする関数を追加した。
2025-10-30 次のアイテムのHITで得点を加算する機能を実装しました： - ボールセパレータ - ボールスルー - バンパー
2025-10-30 次のアイテムのHITで得点を加算する機能を実装しました： - スタンダップターゲット - スリングショット
2025-10-30 次のアイテムのHITで得点を加算する機能を実装しました： - ジャンパー - エクストラボール
2025-10-30 次のアイテムのHITで得点を加算する機能を実装しました： - ドロップターゲット - タイマー
    ドロップターゲットのどれかに当てることでタイマー開始
    時間内に全てのドロップターゲットを上げると次のステージへ
    ステージが上がると得点の倍率が上がるようにしました。
2025-10-30 スコア送信時のデバッグメッセージを表示しないように修正
2025-10-30 受信したCANメッセージをシリアルに表示しないようにした
2025-10-30 IDEの設定ファイルを修正
2025-10-30 スタートボタンでBGM再生、ゲームオーバーで停止する機能を実装 ステージ遷移でBGMを切り替える機能を実装
2025-10-31 シリアル通信で受信したコマンドに基づき、DFPlayerMiniを操作する機能を追加しました。
2025-10-31 コマンド受信時のアンサーバックを追加して、通信の信頼性を向上させる。
2025-10-31 ステージ番号表示機能を追加した。 NeoPixel LEDの制御コードを削除した。
2025-10-31 ステージ番号をタイマーに表示するようにした。
2025-10-31 ボールが落ちた時、盤面を初期化するよう修正
2025-10-31 ヘッダファイルのコメントが不適切だったのを修正
2025-10-31 効果音用の定義を追加
2025-10-31 ボールが落ちたとき、得点までクリアされてしまっていた問題を修正
2025-10-31 ステージ番号送信処理をgame_logic()の中からinit_board()の中に移動しました。
2026-07-28 新アイテムコントローラー基板のデータを追加
2026-10-16 新7セグ・タイマー制御基板のデータを追加
2026-10-16 新メイン制御基板のデータを追加
2026-10-16 新センサー基板（フォトインタラプタ）のデータを追加
2026-10-16 自己保持型ソレノイド制御基板のデータを追加
2026-10-16 メインコントローラーとタイマーの初期コミット
2026-10-16 ドロップターゲットの初期コミット
2026-10-18 アウトホールの初期コミット
2026-10-20 各アイテムごとに作っていたプロジェクトを1つにまとめるようにしている。 まずは、ドロップターゲット、エクストラボール、アウトホール、スタンダップターゲット、タイマー7セグをまとめた。
    まとめたアイテムに合わせて、メインコントローラーのLCD表示のコードも修正した。
2026-10-20 バンパーの制御コードを追加した。
2026-10-20 スリングショットの制御コードを追加した。
2026-10-20 ジャンパーの制御コードを追加した。
2026-10-20 ボールセパレータとボールスルーの制御コードを追加した。
2026-10-20 CAN通信で用いる定数を修正した。
2026-10-20 30連LEDの制御コードを追加した。
2026-10-21 得点板の制御コードを追加した。
2026-10-21 フリッパーの制御コードを追加した。
2026-10-21 def-can.h ファイルのコミットし忘れ。
2026-10-21 各アイテムのプロジェクトをitem-controllerにまとめたので、不要なプロジェクトを削除した。
